HeyPCB/iris/cad/out/envelopes/README.md

# Purchased-part envelopes

Simplified envelopes drawn from datasheet main dimensions for clearance work. They are not
vendor CAD and do not show internal detail.

| File | Part | Source | Frame |
|---|---|---|---|
| `scs0009_envelope.step` | Feetech SCS0009 bus servo | Feetech SCS0009 product specification 2020-11-23, p.6 outline (case 23.3 x 12.1 x 25.25, spline 3.2, ears 32.5, holes 28.5) | origin 1.0 mm above the spline tip on the shaft axis, +Z along the shaft, +X along the long side |
| `ov2640_module_envelope.step` | OV2640 module, Union Image ZY-XSF3M2640B type | Seeed OV2640 module datasheet p.7 drawing (holder 8.5 x 8.5, lens 7.2 / 5.4, stack 5.54) | origin at the module back face on the optical axis, +X out of the lens; FPC neck stub toward -Y |
