HeyPCB/iris/media/gaze_up.png

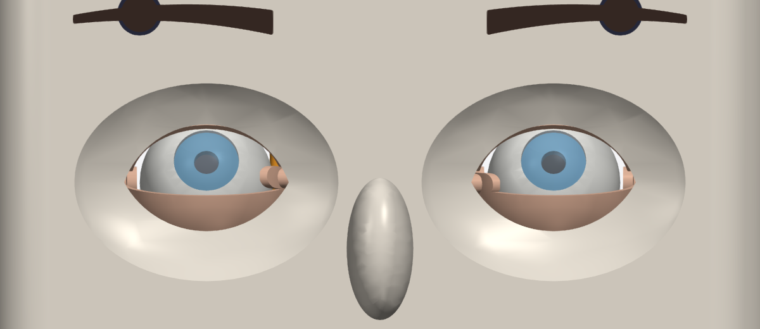
media/gaze_up.png
