HeyPCB/iris/cad/out/iris_assembly.step

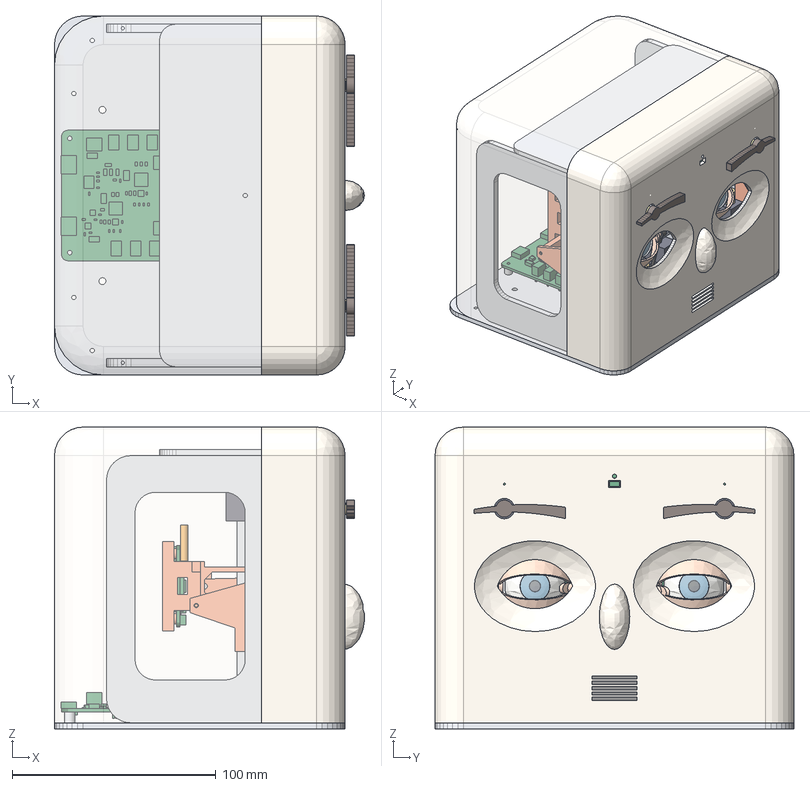
[picture p7: CAD file, 2026-10-03]
cad/out/iris_assembly.step
152.0 x 176.0 x 148.0 mm
column
nose_block
side_plate_R
side_plate_L
top_bridge
base_plate
back_cover
face_shell
servo_tilt
servo_lidU_R
servo_lidU_L
servo_lidL_R
servo_lidL_L
servo_brow_R
servo_brow_L
temple_pin_R
temple_pin_L
nasal_pin_R
speaker
B2
B4
brow_cable_frame
spine
fork_R
temple_arm_R
servo_pan_R
pole_pins_R
temporal_pin_R
fork_L
temple_arm_L
servo_pan_L
pole_pins_L
temporal_pin_L
tilt_tongue
tongue_pin
nasal_pin_L
bearing_R
B1
brow_cable_cradle
sclera_R
cornea_R
iris_R
carrier_R
B3_R
keel_stud_R
camera
pan_crank_R
crank_stud_R
pan_coupler_R
lidU_R
lidU_stud_R
hornU_R
hornU_stud_R
rodU_R
lidL_R
lidL_stud_R
hornL_R
hornL_stud_R
rodL_R
brow_R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
