HeyPCB/iris/cad/out/envelopes/ov2640_module_envelope.step

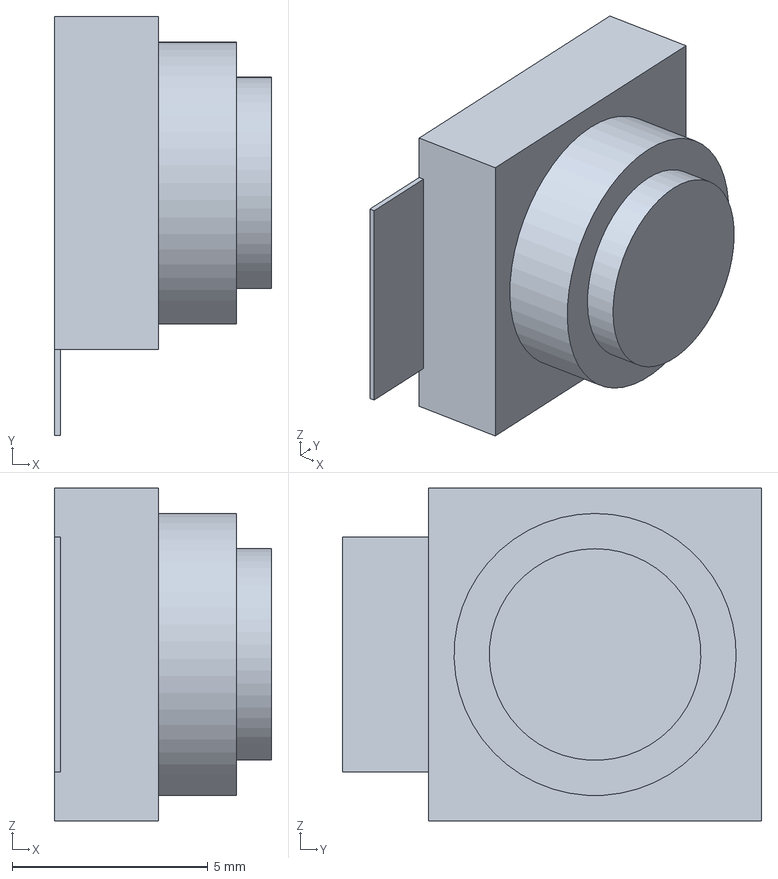
[picture p8: CAD file, 2026-10-03]
cad/out/envelopes/ov2640_module_envelope.step
5.54 x 10.7 x 8.50 mm
