HeyPCB/iris/cad/out/parts/brow_hub.step

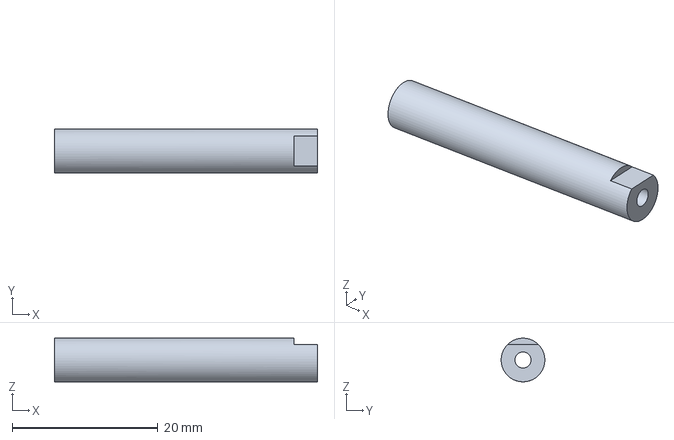
[picture p9: CAD file, 2026-10-03]
cad/out/parts/brow_hub.step
36.1 x 6.00 x 6.00 mm
