HeyPCB/iris/cad/out/envelopes/scs0009_envelope.step

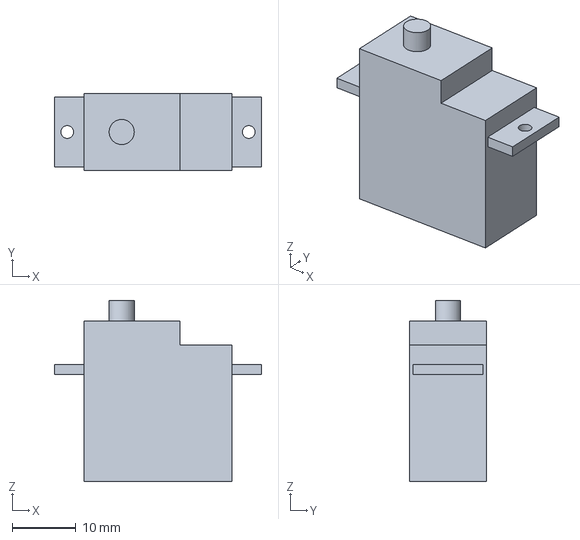
[picture p10: CAD file, 2026-10-03]
cad/out/envelopes/scs0009_envelope.step
32.5 x 12.1 x 28.4 mm
