HeyPCB/iris/cad/out/parts/lid_horn.step

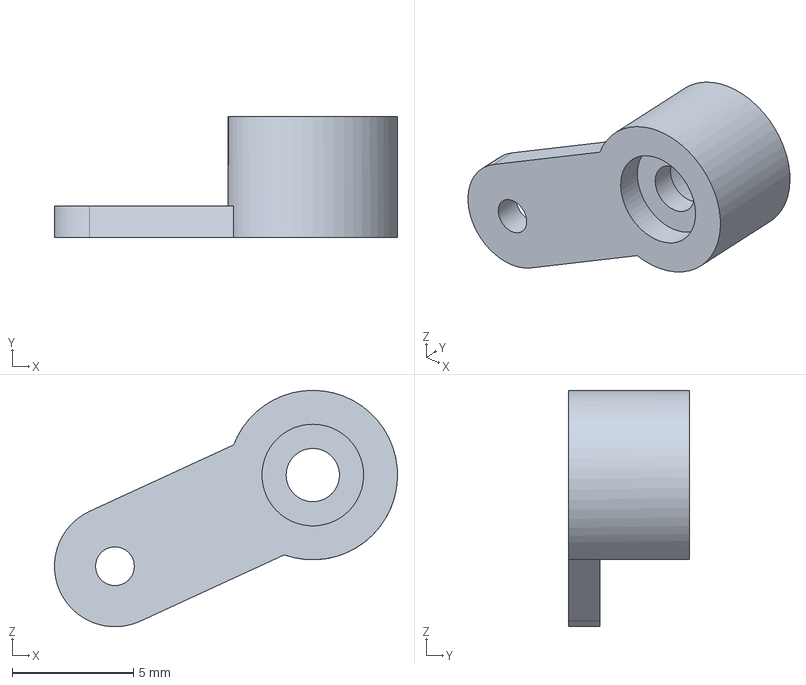
[picture p11: CAD file, 2026-10-03]
cad/out/parts/lid_horn.step
14.2 x 5.00 x 9.76 mm
