HeyPCB/iris/cad/out/parts/pan_crank.step

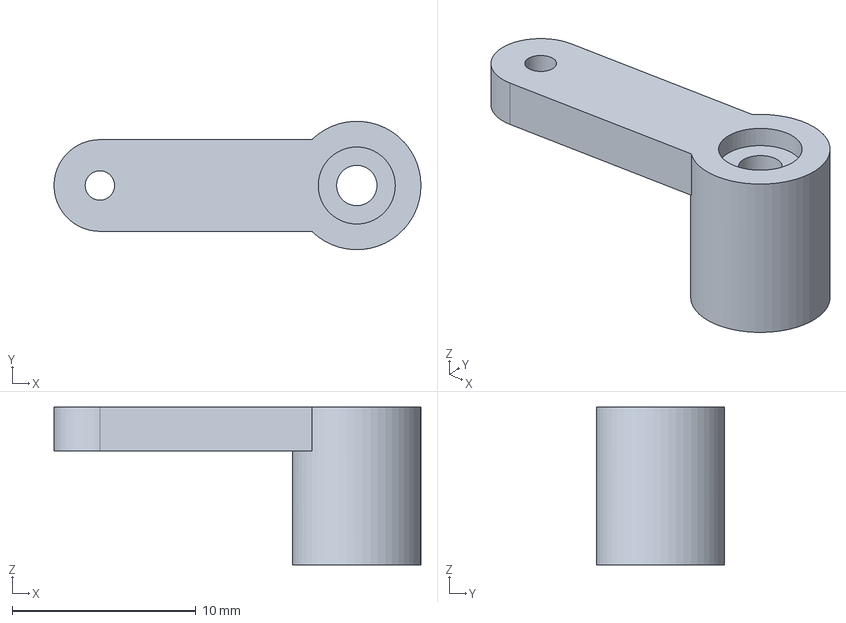
[picture p12: CAD file, 2026-10-03]
cad/out/parts/pan_crank.step
20.0 x 7.00 x 8.60 mm
