HeyPCB/iris/cad/out/parts/spine.step

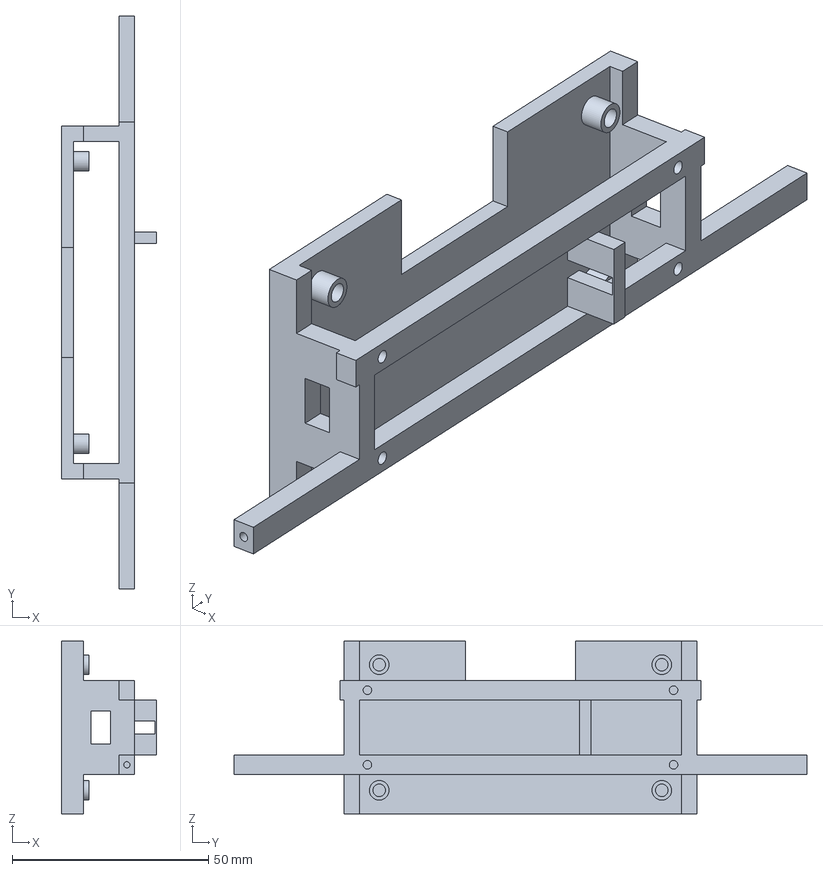
[picture p13: CAD file, 2026-10-03]
cad/out/parts/spine.step
24.1 x 146.0 x 44.0 mm
