HeyPCB/iris/cad/out/parts/back_cover.step

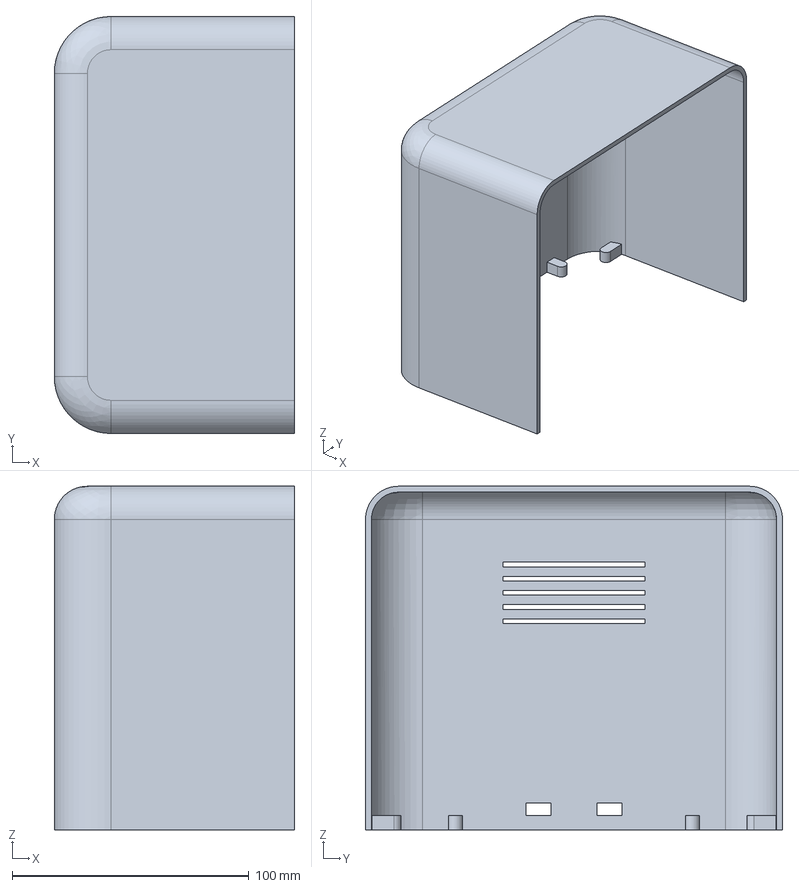
[picture p14: CAD file, 2026-10-03]
cad/out/parts/back_cover.step
101.5 x 176.0 x 145.0 mm
