HeyPCB/iris/cad/out/parts/iris_disc.step

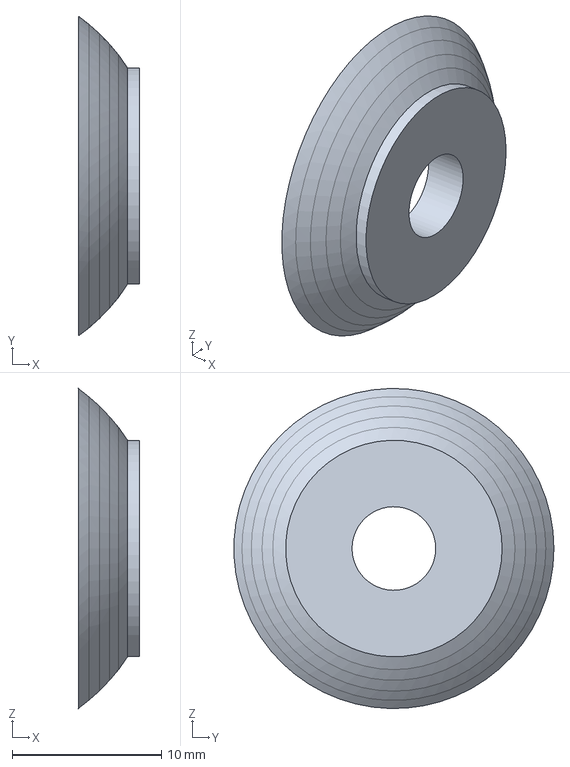
[picture p15: CAD file, 2026-10-03]
cad/out/parts/iris_disc.step
4.10 x 21.4 x 21.4 mm
