HeyPCB/iris/cad/out/parts/side_plate_L.step

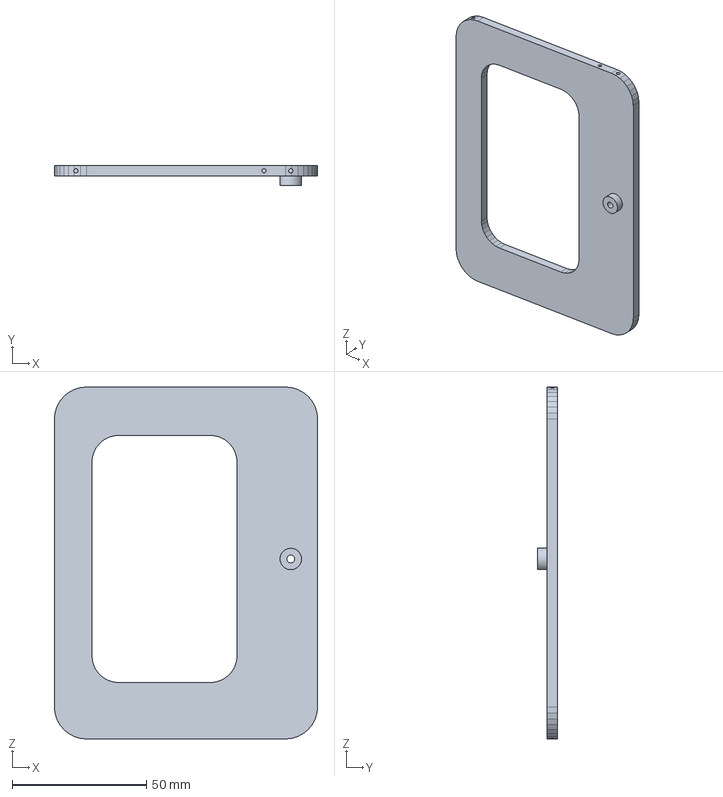
[picture p16: CAD file, 2026-10-03]
cad/out/parts/side_plate_L.step
98.0 x 7.50 x 131.0 mm
