HeyPCB/iris/cad/out/parts/top_bridge.step

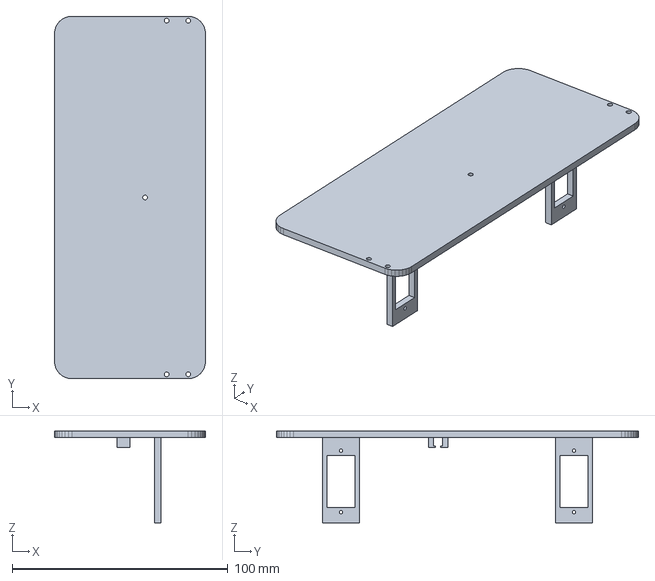
[picture p17: CAD file, 2026-10-03]
cad/out/parts/top_bridge.step
70.0 x 168.0 x 42.5 mm
