HeyPCB/iris/cad/out/parts/face_shell.step

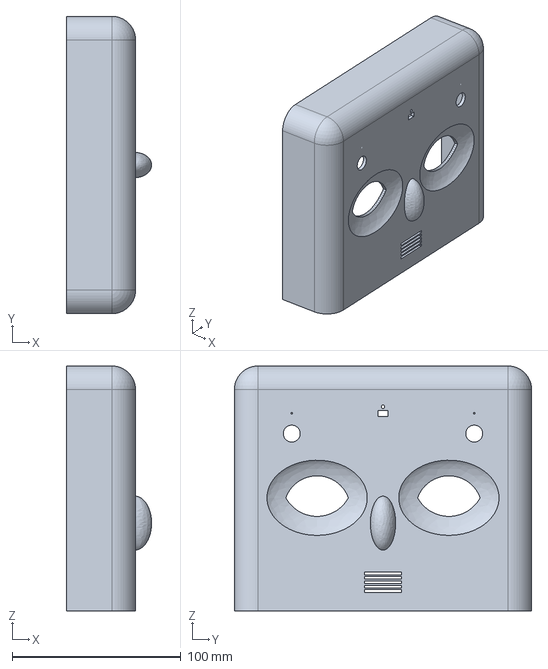
[picture p18: CAD file, 2026-10-03]
cad/out/parts/face_shell.step
50.5 x 176.0 x 145.0 mm
