HeyPCB/iris/cad/out/parts/brow_R.step

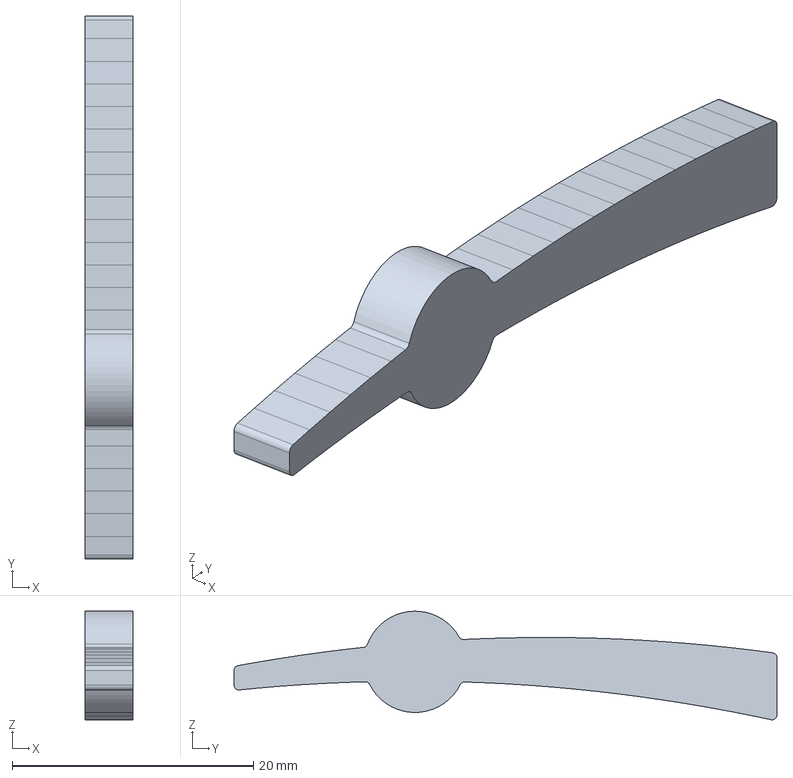
[picture p19: CAD file, 2026-10-03]
cad/out/parts/brow_R.step
4.00 x 45.0 x 9.01 mm
