HeyPCB/iris/cad/out/parts/lidU_R.step

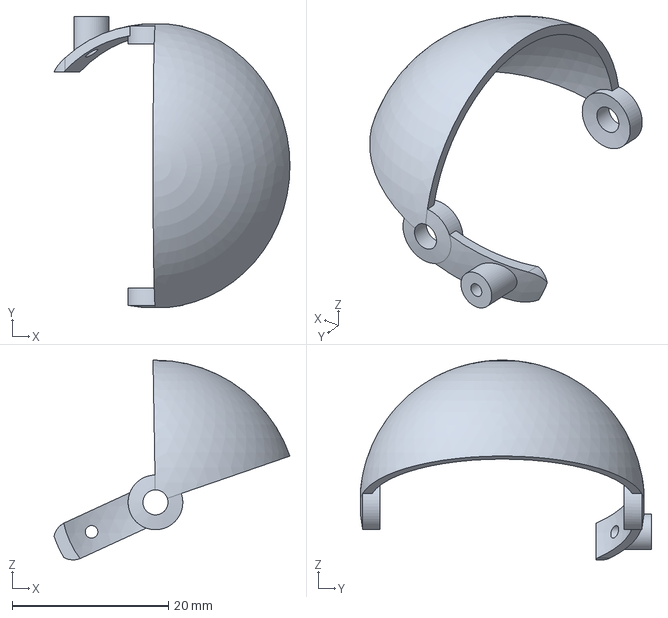
[picture p20: CAD file, 2026-10-03]
cad/out/parts/lidU_R.step
30.2 x 37.2 x 25.6 mm
