HeyPCB/iris/cad/out/parts/base_plate.step

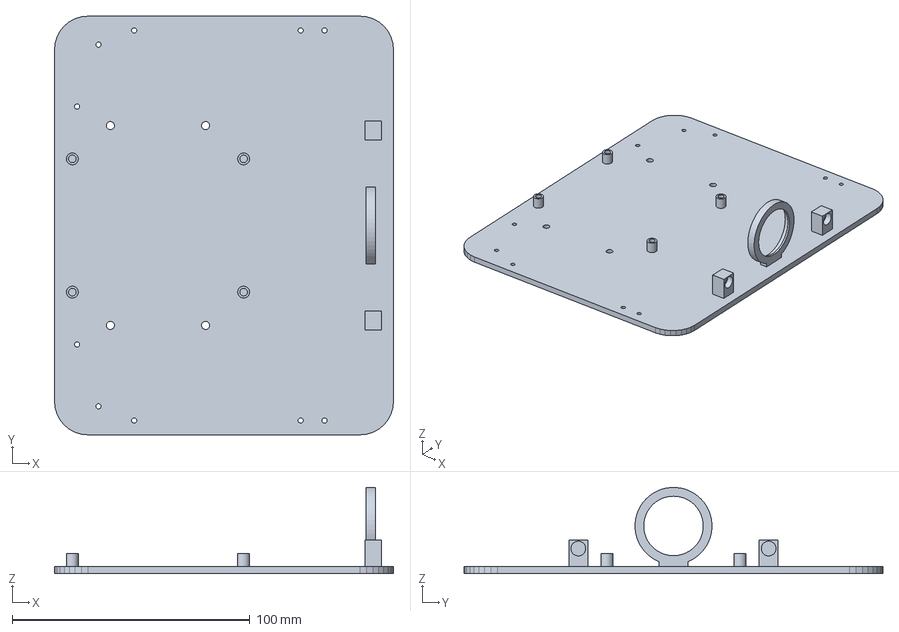
[picture p21: CAD file, 2026-10-03]
cad/out/parts/base_plate.step
142.5 x 176.0 x 36.2 mm
