HeyPCB/iris/cad/out/parts/lidL_R.step

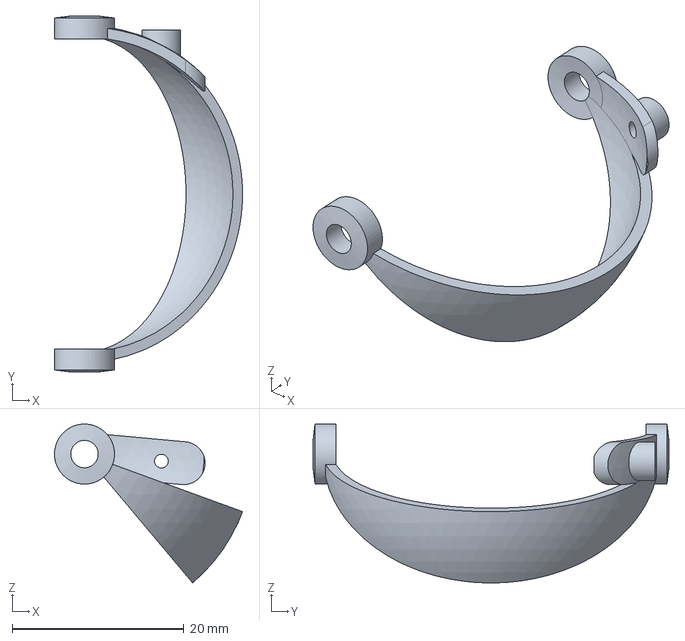
[picture p22: CAD file, 2026-10-03]
cad/out/parts/lidL_R.step
21.9 x 41.5 x 18.5 mm
