HeyPCB/iris/cad/out/parts/lidU_L.step

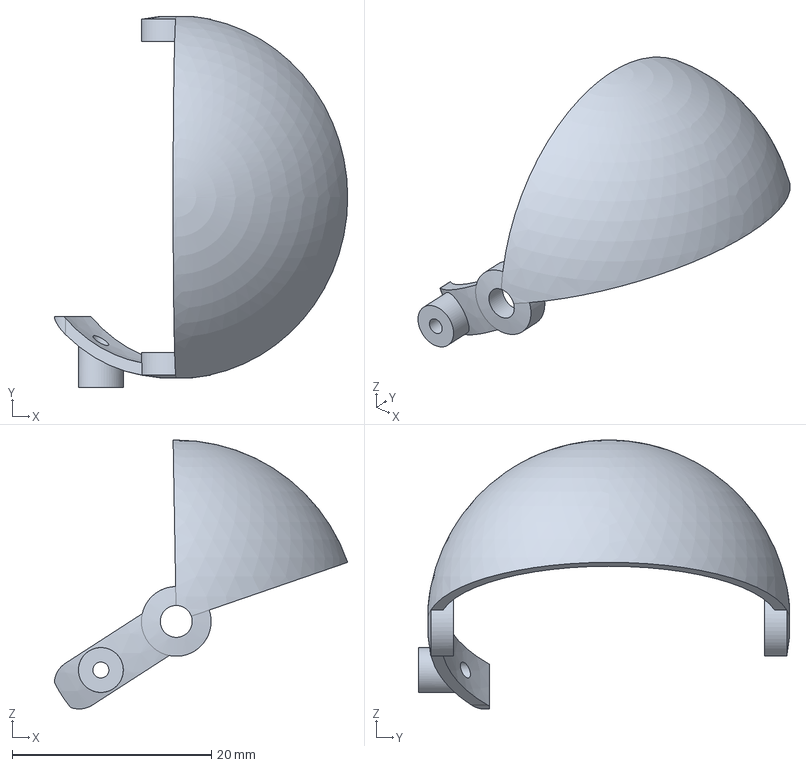
[picture p23: CAD file, 2026-10-03]
cad/out/parts/lidU_L.step
29.5 x 37.2 x 27.0 mm
