HeyPCB/iris/cad/out/parts/temple_arm_L.step

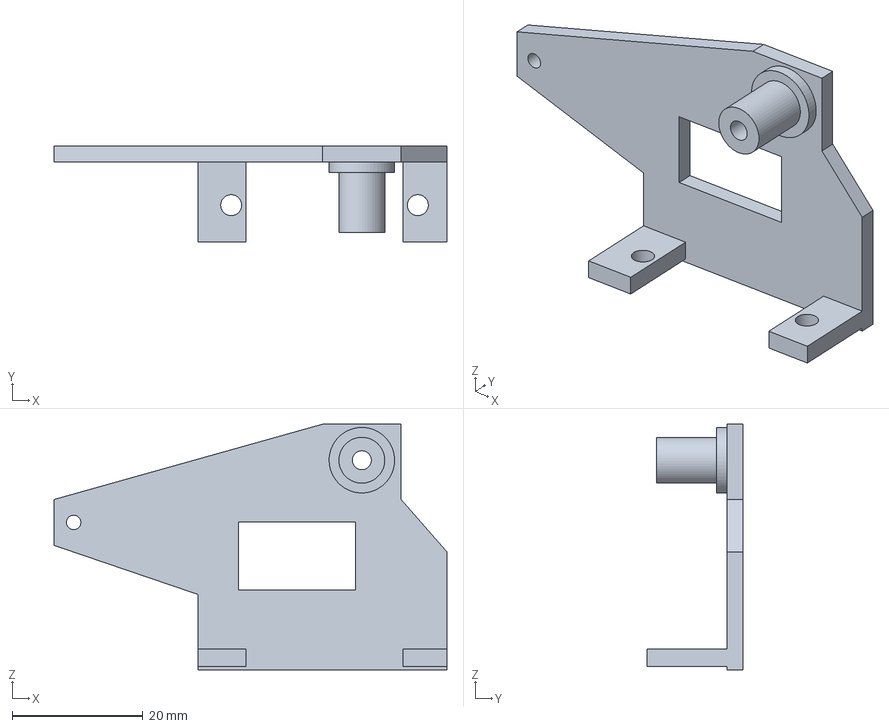
[picture p24: CAD file, 2026-10-03]
cad/out/parts/temple_arm_L.step
60.0 x 14.6 x 37.5 mm
