HeyPCB/iris/cad/out/parts/carrier_L.step

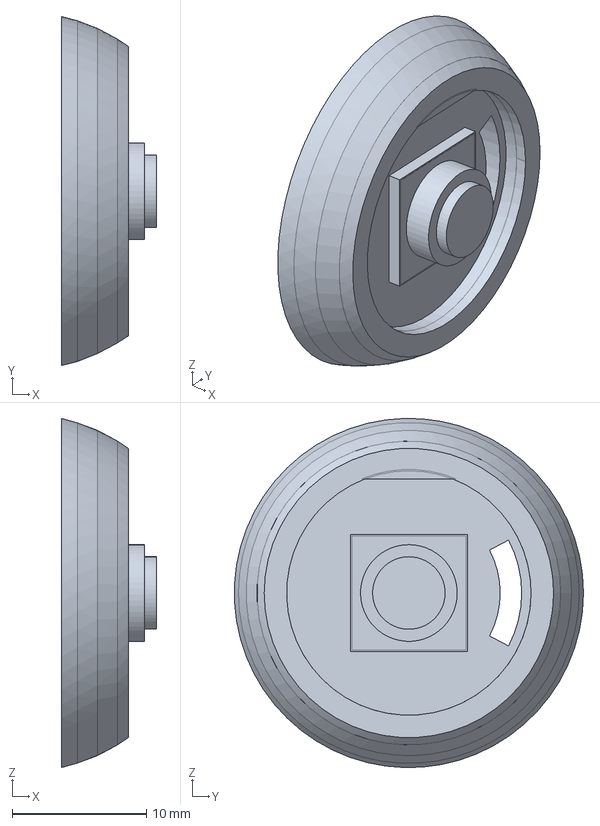
[picture p25: CAD file, 2026-10-03]
cad/out/parts/carrier_L.step
7.10 x 26.0 x 26.0 mm
