HeyPCB/iris/cad/out/parts/column.step

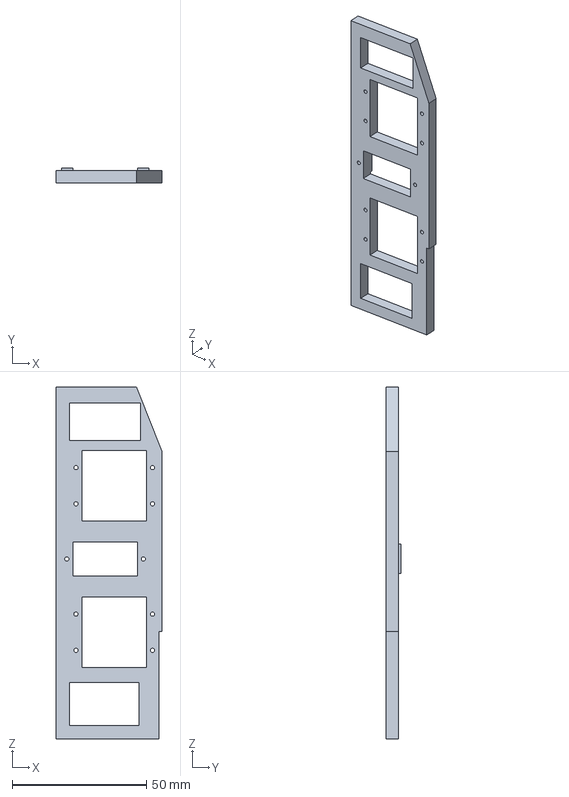
[picture p26: CAD file, 2026-10-03]
cad/out/parts/column.step
39.5 x 5.65 x 131.0 mm
