HeyPCB/iris/cad/out/parts/cornea.step

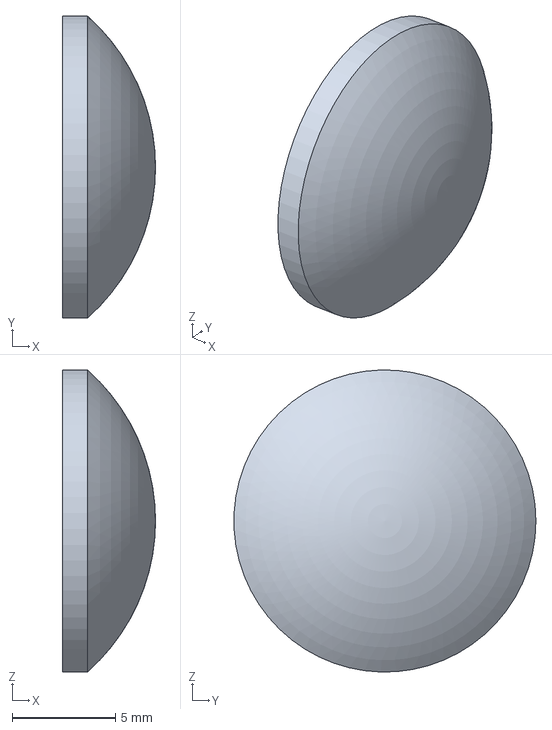
[picture p27: CAD file, 2026-10-03]
cad/out/parts/cornea.step
4.50 x 14.6 x 14.6 mm
