HeyPCB/iris/cad/out/parts/sclera.step

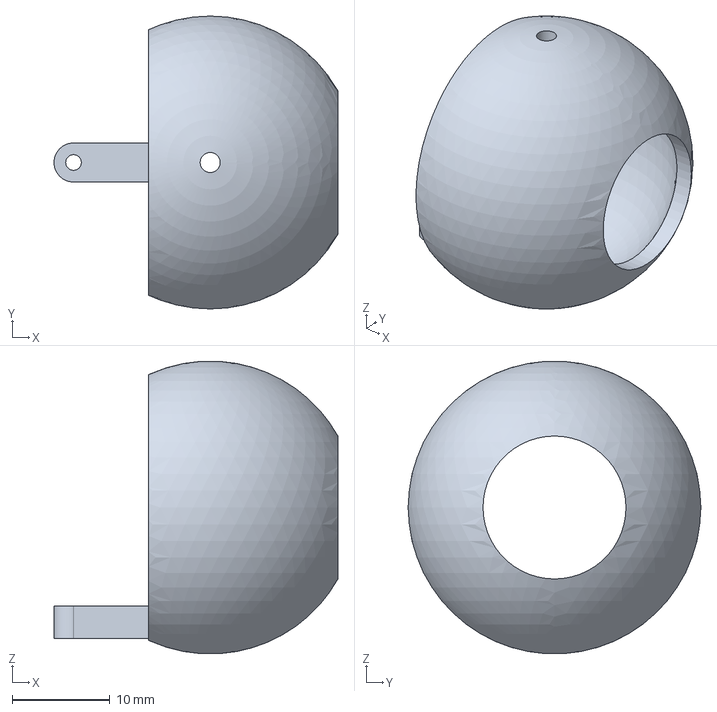
[picture p28: CAD file, 2026-10-03]
cad/out/parts/sclera.step
29.1 x 30.0 x 29.9 mm
