HeyPCB/iris/cad/out/parts/fork.step

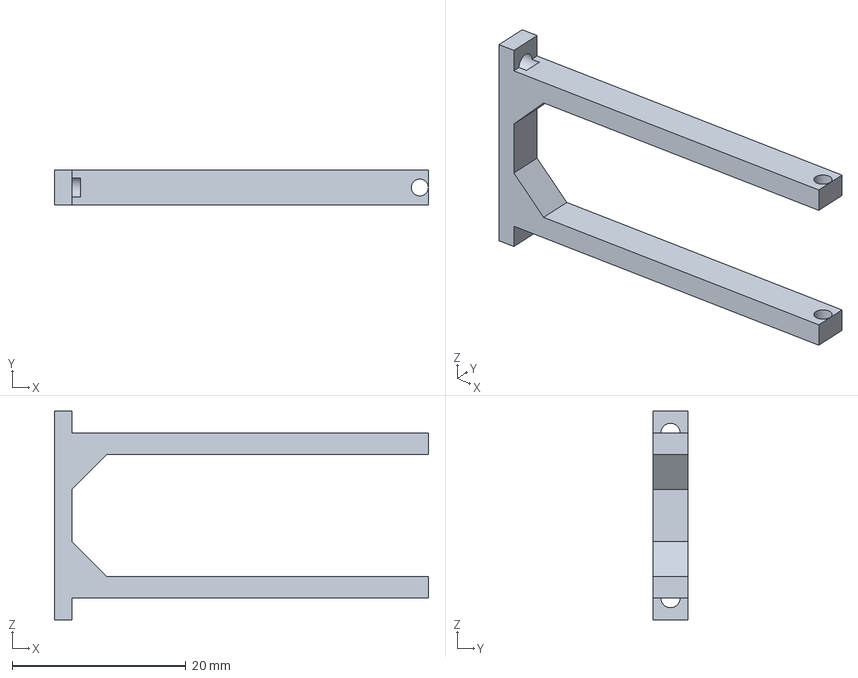
[picture p29: CAD file, 2026-10-03]
cad/out/parts/fork.step
43.0 x 4.00 x 24.0 mm
