HeyPCB/iris/cad/out/parts/tilt_tongue.step

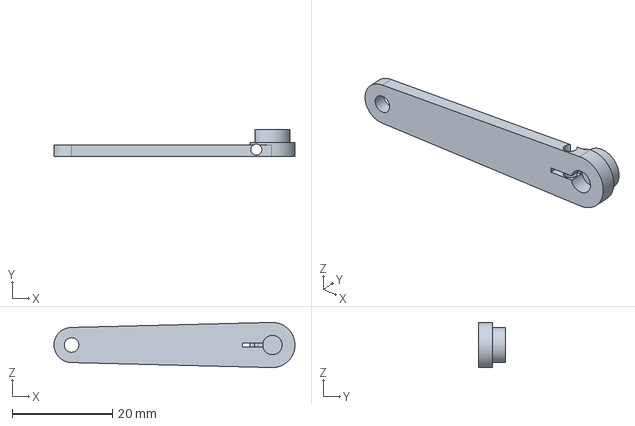
[picture p30: CAD file, 2026-10-03]
cad/out/parts/tilt_tongue.step
48.0 x 5.35 x 9.00 mm
