HeyPCB/iris/cad/out/parts/carrier_R.step

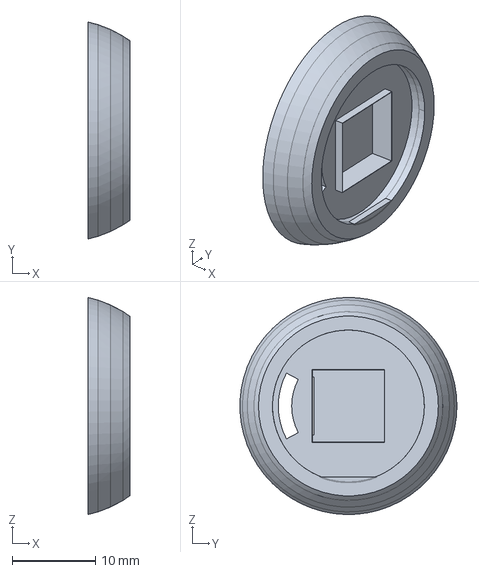
[picture p31: CAD file, 2026-10-03]
cad/out/parts/carrier_R.step
5.00 x 26.0 x 26.0 mm
