HeyPCB/iris/cad/out/parts/nose_block.step

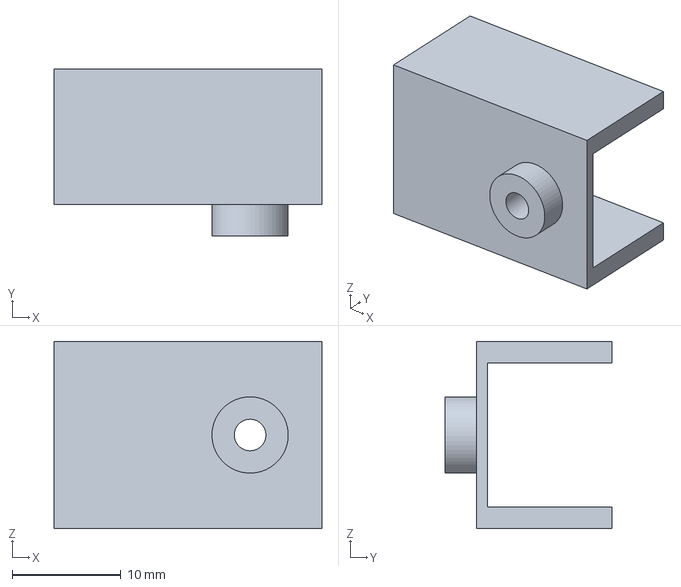
[picture p32: CAD file, 2026-10-03]
cad/out/parts/nose_block.step
24.6 x 15.3 x 17.2 mm
