HeyPCB/iris/(list of files, cad)

Other CAD files:
cad/out/parts/side_plate_R.step
cad/out/parts/brow_L.step
cad/out/parts/lidL_L.step
cad/out/parts/temple_arm_R.step
cad/out/parts/back_cover.stl
cad/out/parts/base_plate.stl
cad/out/parts/brow_L.stl
cad/out/parts/brow_R.stl
cad/out/parts/brow_hub.stl
cad/out/parts/carrier_L.stl
cad/out/parts/carrier_R.stl
cad/out/parts/column.stl
cad/out/parts/cornea.stl
cad/out/parts/face_shell.stl
cad/out/parts/fork.stl
cad/out/parts/iris_disc.stl
cad/out/parts/lidL_L.stl
cad/out/parts/lidL_R.stl
cad/out/parts/lidU_L.stl
cad/out/parts/lidU_R.stl
cad/out/parts/lid_horn.stl
cad/out/parts/nose_block.stl
cad/out/parts/pan_crank.stl
cad/out/parts/sclera.stl
cad/out/parts/side_plate_L.stl
cad/out/parts/side_plate_R.stl
cad/out/parts/spine.stl
cad/out/parts/temple_arm_L.stl
cad/out/parts/temple_arm_R.stl
cad/out/parts/tilt_tongue.stl
cad/out/parts/top_bridge.stl
