HeyPCB/iris/(commit log)

2026-10-03 Iris mechanism v1: parametric CAD, motion check, board fit, docs
    Original CadQuery design of the Iris robot head mechanism from the
    system spec v0.1: Helmholtz tilt cradle, inside-out pan forks with 1:1
    parallelograms, nested visor lids on 1:1 pushrods, brows, frame, base,
    face shell and back cover. Every printed part (P1-P17) is exported as
    STEP and watertight STL, with SCS0009 and OV2640 envelopes drawn from
    datasheet dimensions.
    cad/check.py sweeps every pair of moving groups over the joints that
    move them (pan, tilt, lids inside the gaze-following envelope, brows),
    including the pushrods and ball links the concept model skipped: no
    collisions, >= 0.5 mm moving and >= 0.3 mm static clear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
    [back_cover.step, back_cover.stl, base_plate.step, base_plate.stl, brow_L.step, brow_L.stl, brow_R.step, brow_R.stl]
2026-10-03 Fit the released boards and adapt the mechanism to them
    The four Iris boards are final. cad/fit.py and cad/check.py now place
    the real KiCad 10.0.6 STEP exports through the binding board-to-head
    maps (normalised to the ordered thickness: 1.6 mm, B3 0.8 mm), add
    envelopes for parts whose 3D model is missing from the exports, and
    sweep each board with everything that moves relative to it.
    Changes the as-built boards required:
    - iris cone ring clamps B3 outside r 8.4 (its LEDs reach r 8.09)
    - arc slot in the eye carrier for B3's wire pads (r 7.6, 2.1 mm pitch)
    and a deeper pocket for its back-side parts
    - face-shell ALS window moved to B4's as-built position; solid pads in
    front of the two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
    [back_cover.step, base_plate.step, brow_L.step, brow_R.step, brow_hub.step, carrier_L.step, carrier_L.stl, carrier_R.step]
2026-10-03 Say where the spec's binding tables live
    The docs cite "spec N" sections of the Iris system specification v0.1,
    which is not published. Say so once in the README, point at
    docs/system.md for its binding tables and docs/mechanism.md for the
    departures, and make this page authoritative for public readers.
    [params.py]
